PauloDevelo/EngineMonitor/documentation/illustrations/photos/IMG_8459.JPG

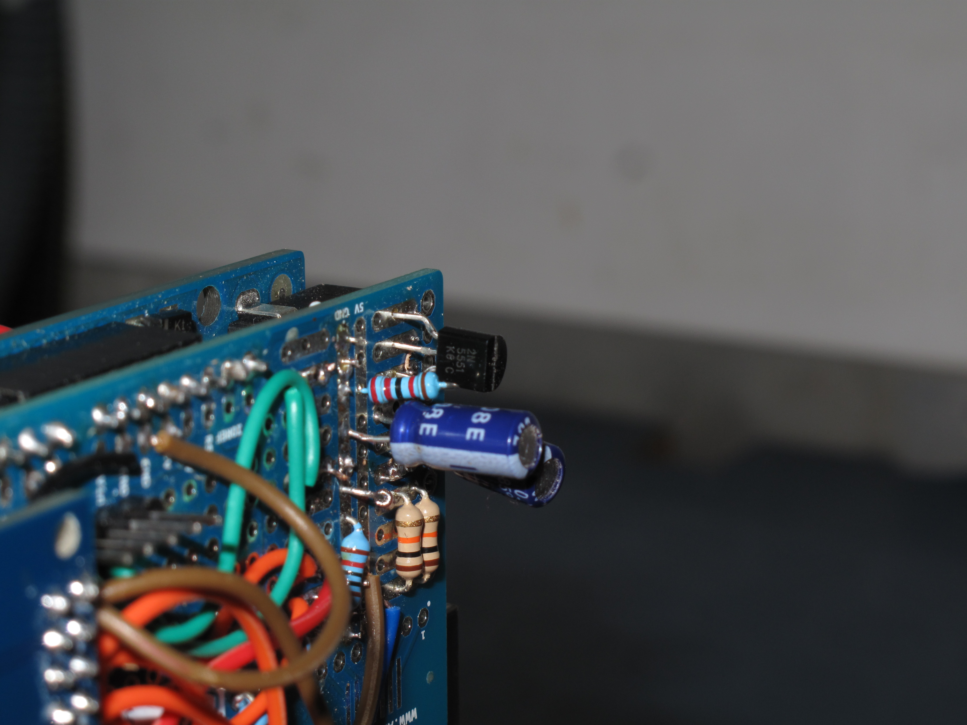
documentation/illustrations/photos/IMG_8459.JPG
