PauloDevelo/EngineMonitor/documentation/illustrations/photos/IMG_8458.JPG

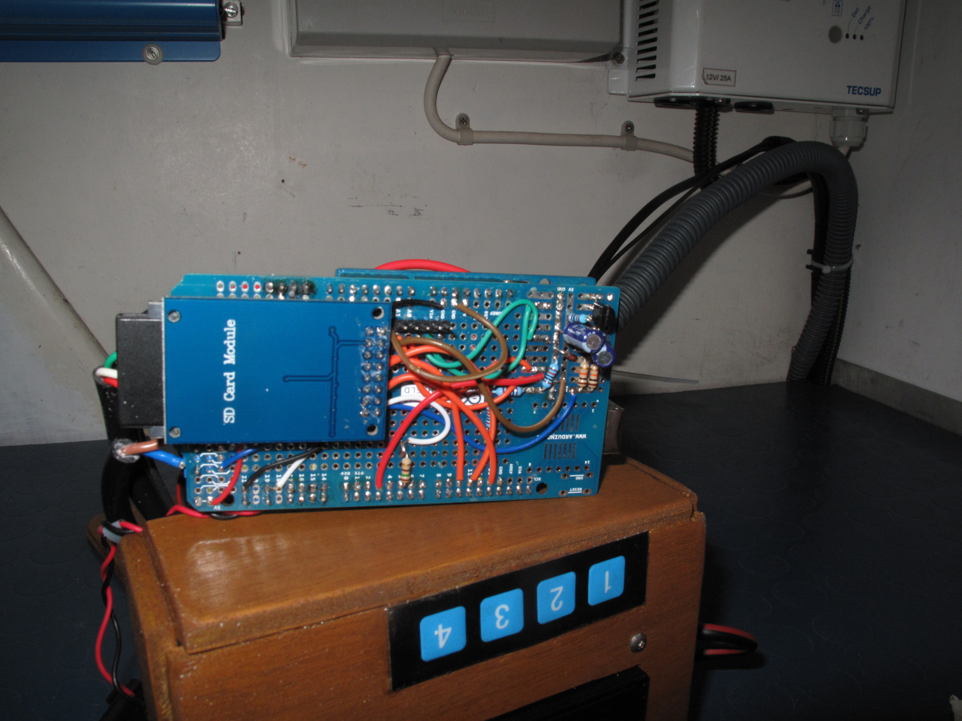
documentation/illustrations/photos/IMG_8458.JPG
