PauloDevelo/EngineMonitor/tools/readme.txt

Cet utilitaire permet de lire un ancien fichier de config et de le modifier pour cet nouvelle version.
Il faudra modifier cet utilitaire afin de faire un assistant de création de ce fichier ...
