PauloDevelo/EngineMonitor/documentation/annexes/electronique_compte_tours_001_entree_001.gif

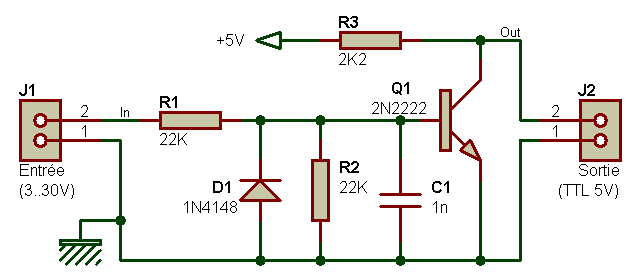
documentation/annexes/electronique_compte_tours_001_entree_001.gif
