PauloDevelo/EngineMonitor/documentation/illustrations/adaptation_W.JPG

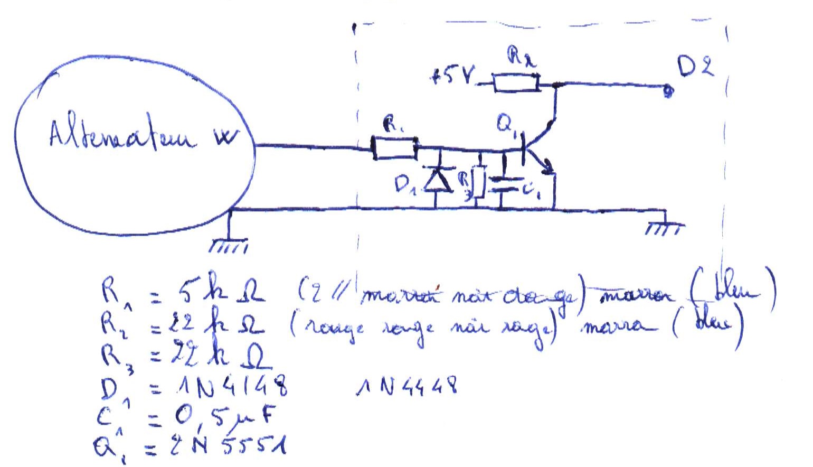
documentation/illustrations/adaptation_W.JPG
