PauloDevelo/EngineMonitor/documentation/illustrations/alim.jpg

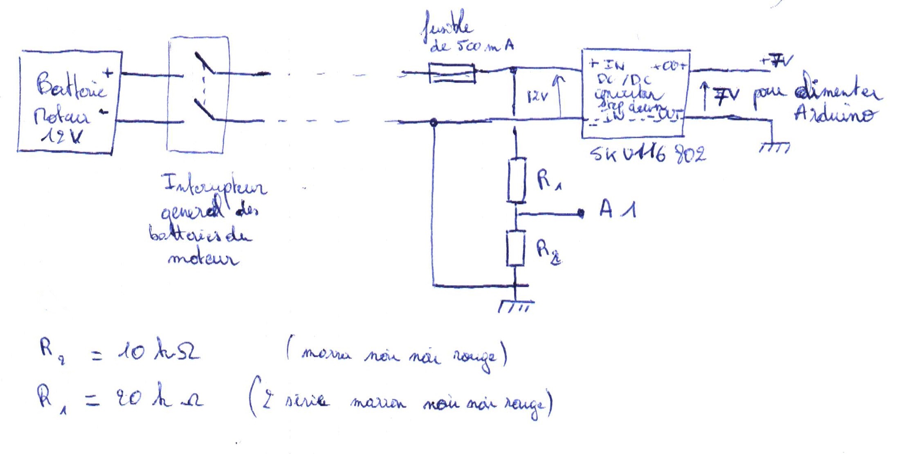
documentation/illustrations/alim.jpg
