PauloDevelo/EngineMonitor/documentation/illustrations/boutons.jpg

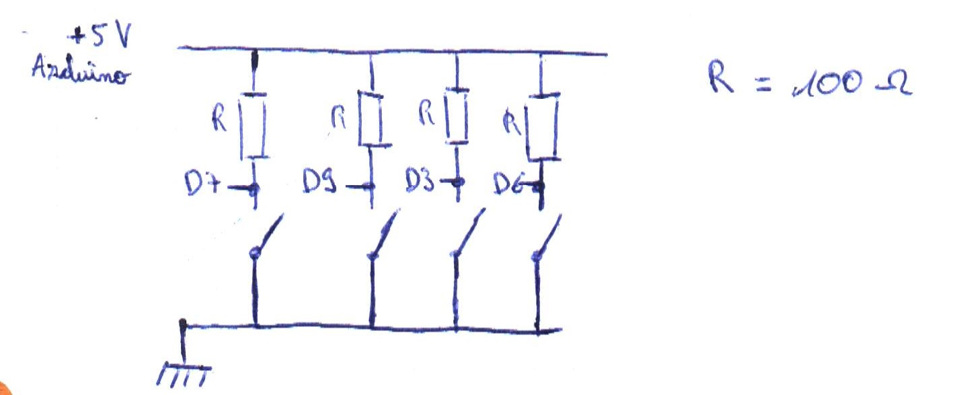
documentation/illustrations/boutons.jpg
