PauloDevelo/EngineMonitor/documentation/illustrations/buzzer.jpg

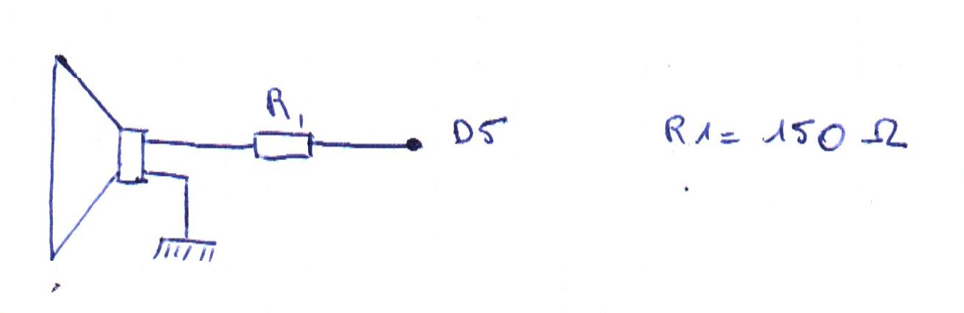
documentation/illustrations/buzzer.jpg
