PauloDevelo/EngineMonitor/documentation/illustrations/config_BT.JPG

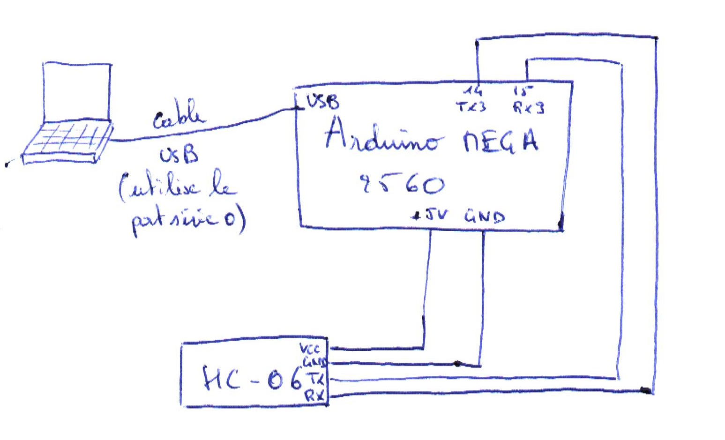
documentation/illustrations/config_BT.JPG
