PauloDevelo/EngineMonitor/documentation/illustrations/courbe_conso.jpg

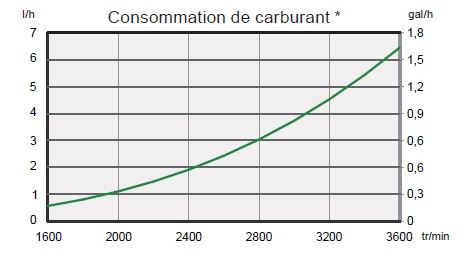
documentation/illustrations/courbe_conso.jpg
