PauloDevelo/EngineMonitor/documentation/illustrations/ecran_lcd.jpg

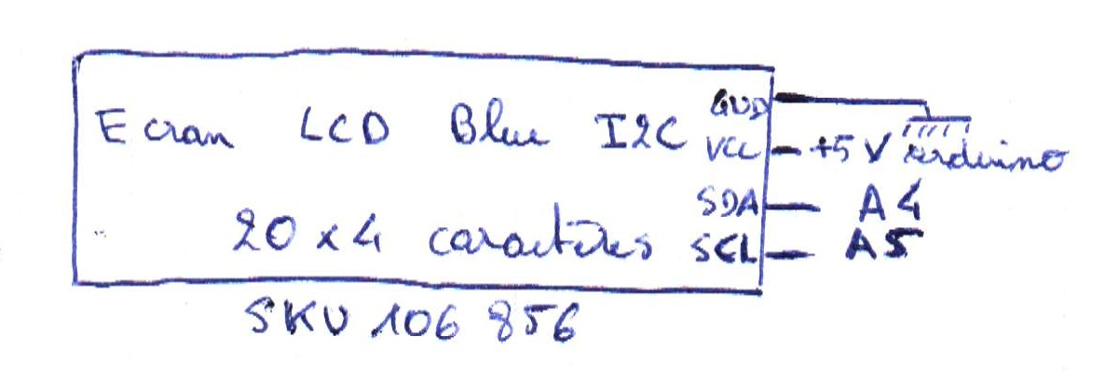
documentation/illustrations/ecran_lcd.jpg
