PauloDevelo/EngineMonitor/documentation/illustrations/gestionnaire_moteur.jpg

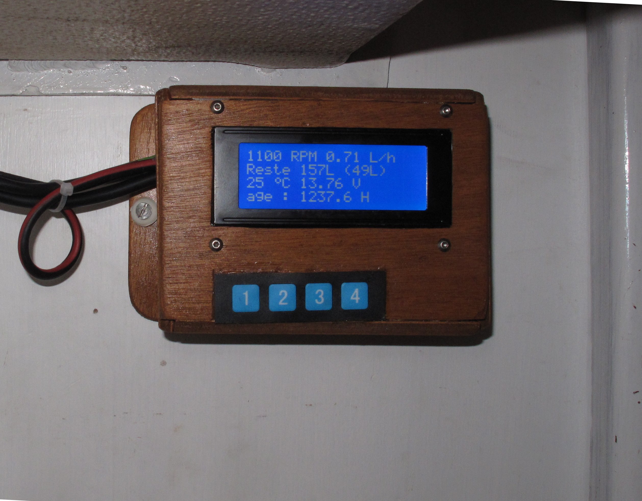
documentation/illustrations/gestionnaire_moteur.jpg
