PauloDevelo/EngineMonitor/documentation/illustrations/module_BT.jpg

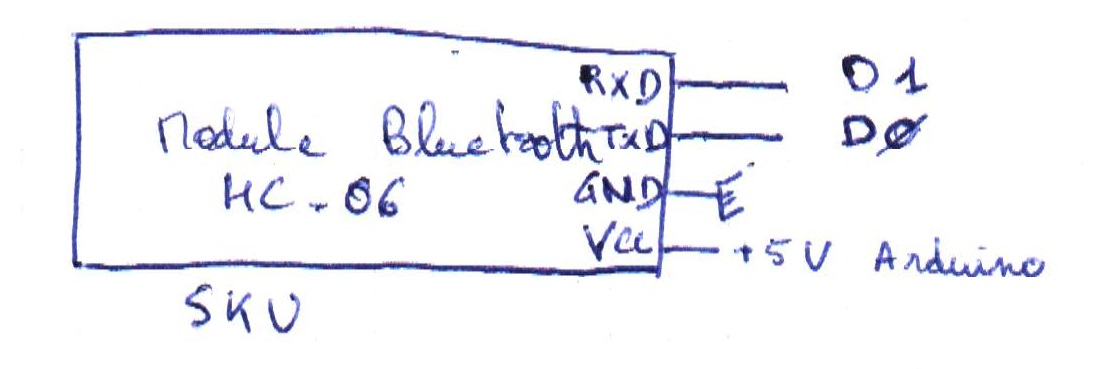
documentation/illustrations/module_BT.jpg
