PauloDevelo/EngineMonitor/documentation/illustrations/module_sd.jpg

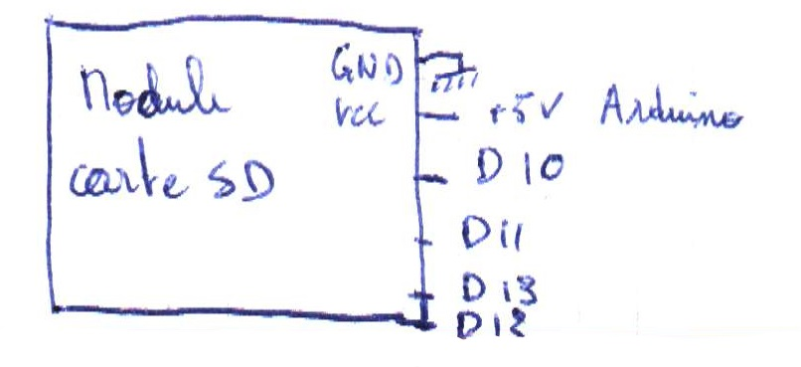
documentation/illustrations/module_sd.jpg
