PauloDevelo/EngineMonitor/documentation/illustrations/photos/IMG_8455.JPG

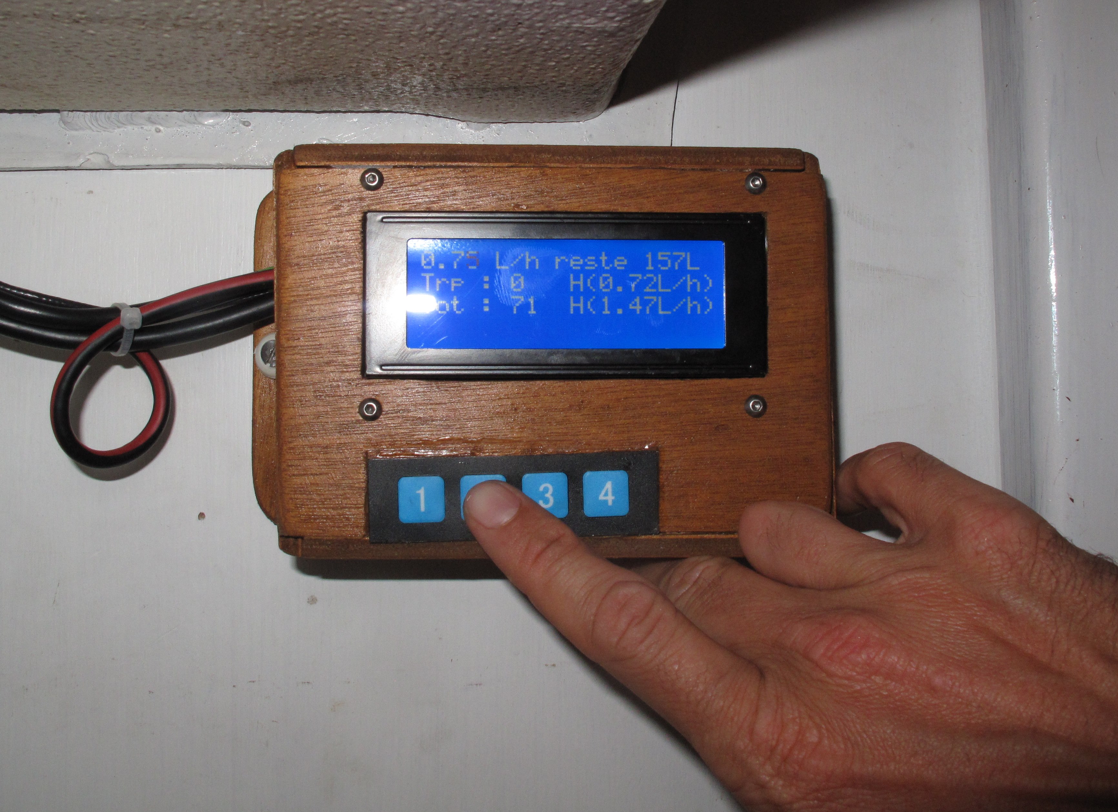
documentation/illustrations/photos/IMG_8455.JPG
