PauloDevelo/EngineMonitor/documentation/illustrations/photos/IMG_8456.JPG

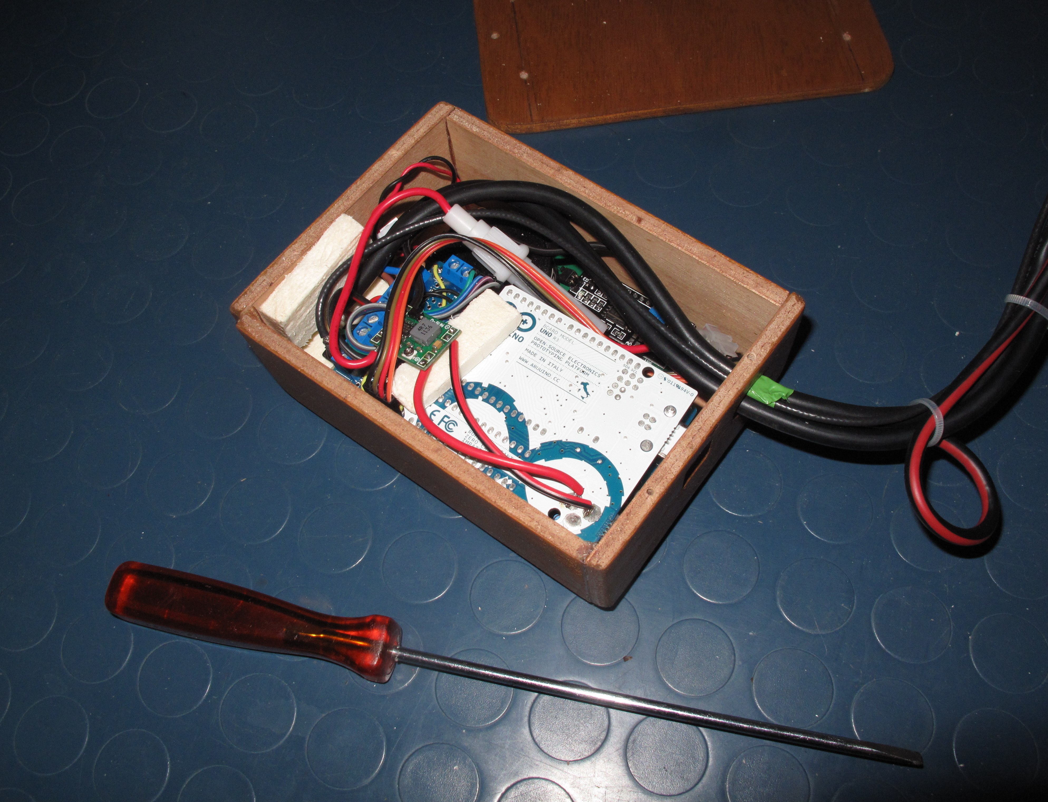
documentation/illustrations/photos/IMG_8456.JPG
