PauloDevelo/EngineMonitor/documentation/illustrations/photos/IMG_8457.JPG

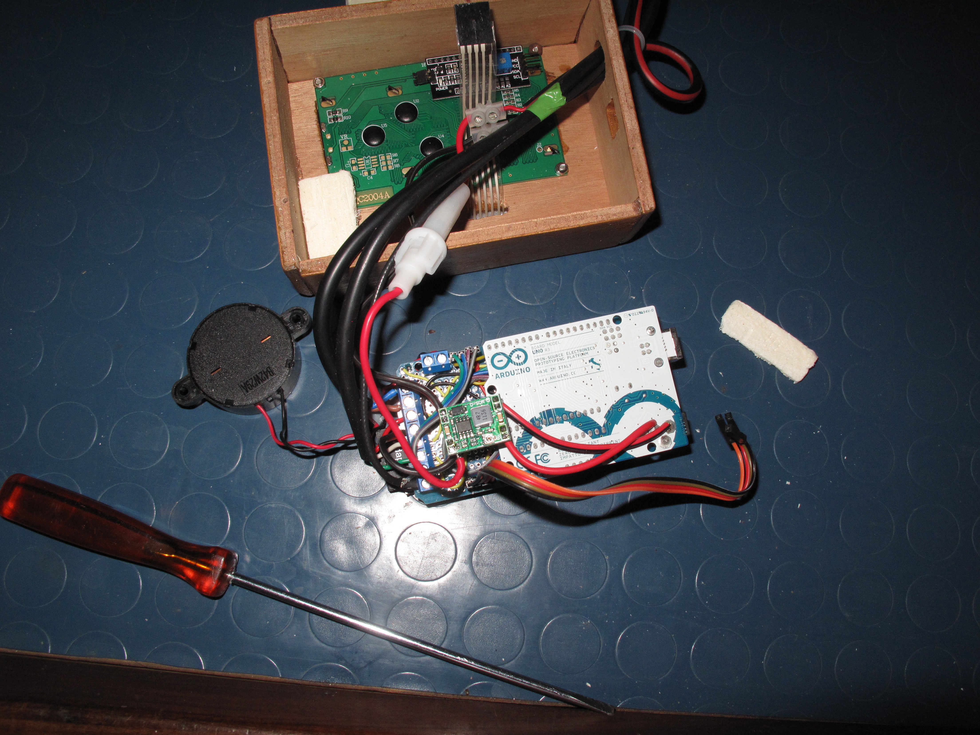
documentation/illustrations/photos/IMG_8457.JPG
