PauloDevelo/EngineMonitor/documentation/illustrations/photos/IMG_8472.JPG

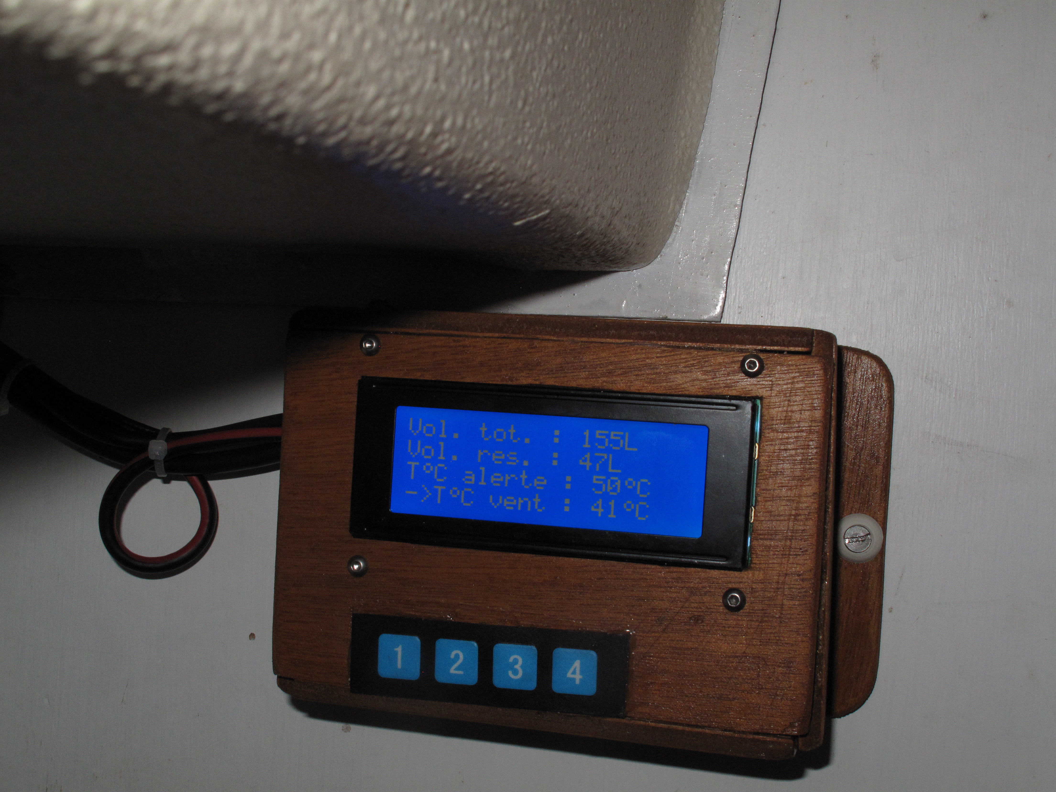
documentation/illustrations/photos/IMG_8472.JPG
