PauloDevelo/EngineMonitor/documentation/illustrations/PTDC0001.JPG

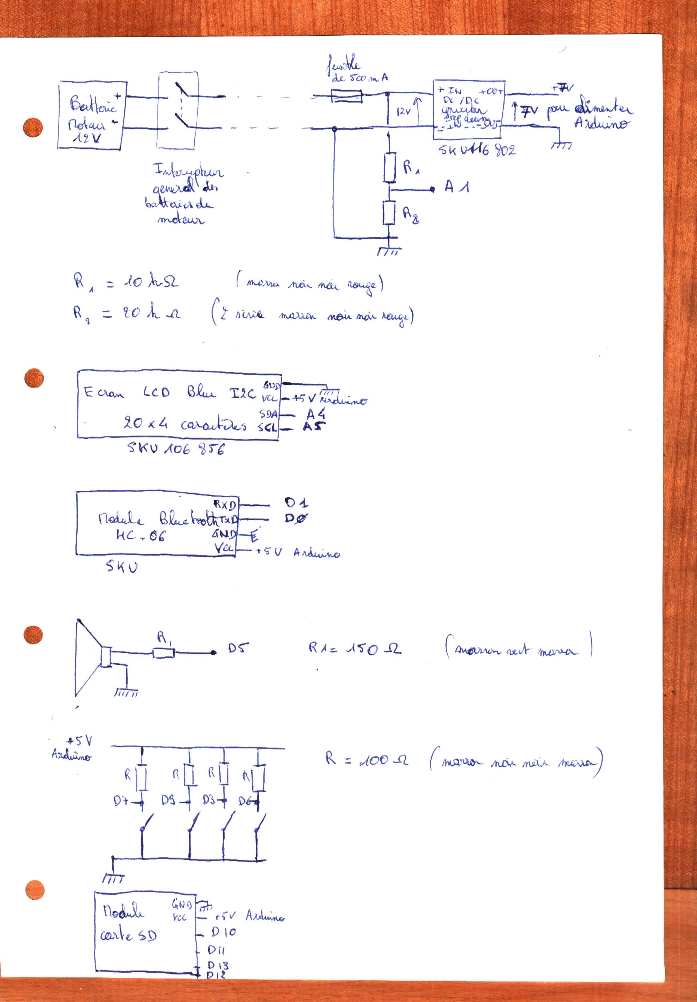
documentation/illustrations/PTDC0001.JPG
