PauloDevelo/EngineMonitor/documentation/illustrations/relais_ventilo.JPG

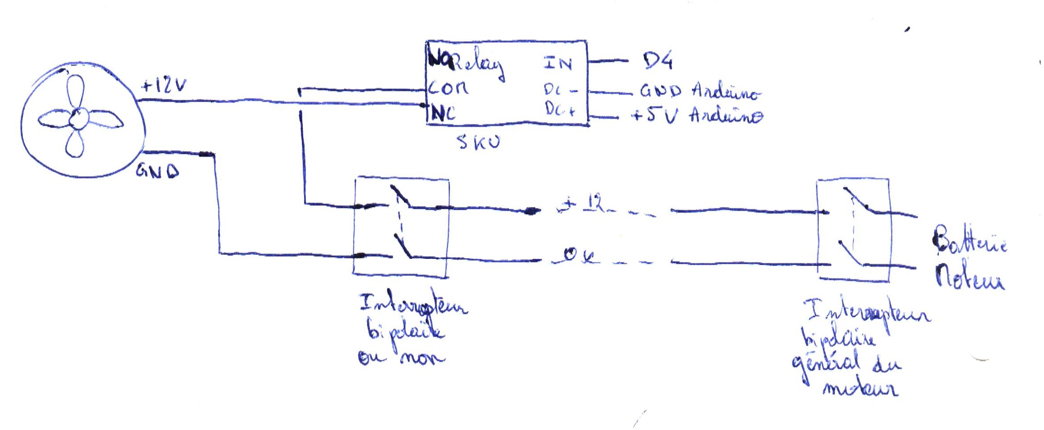
documentation/illustrations/relais_ventilo.JPG
