PauloDevelo/EngineMonitor/documentation/illustrations/thermometre.jpg

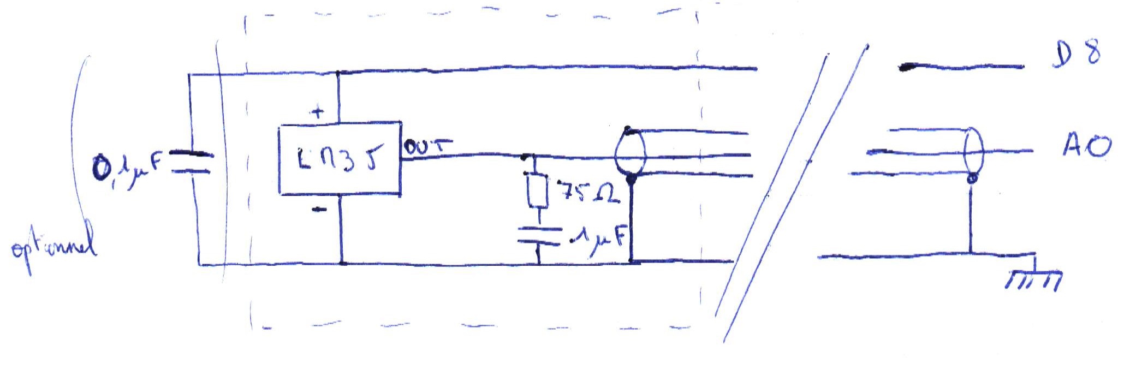
documentation/illustrations/thermometre.jpg
