PauloDevelo/EngineMonitor/Utils.cpp

/*
 *
 * This file is a part of my arduino development.
 * If you make any modifications or improvements to the code, I would
 * appreciate that you share the code with me so that I might include
 * it in the next release. I can be contacted through paul.torruella@gmail.com

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
 * Commercial use of this file and/or every others file from this library requires
 * you to buy a license that will allow commercial use. This includes using the code,
 * modified or not, as a tool to sell products.

 *  The license applies to this file and its documentation.
 *
 *  Created on: 23 févr. 2016
 *  Author: Paul TORRUELLA
 */

#include "Utils.h"

int Utils::FreeRam() {
	char top;
	return __brkval ? &top - __brkval : &top - &__bss_end;
}
