PauloDevelo/EngineMonitor/(commit log)

2016-03-28 Initial add
    Added all the documentations and the sources
    [consommation_nanni3_30.ods]
2019-11-08 Update README.md
    Add some feedback of the arduino system usage
2019-11-09 Post the lastest version of the engine monitor with: The new temperature sensor The usage of the eeprom instead of the sd card to save the context. Usage of the Virtuino library
