PauloDevelo/EngineMonitor/(notices)

Notices in the files:
Utils.cpp:
modify it under the terms of the GNU GENERAL PUBLIC LICENSE 3.0 license.
